FelipeBallesteros0/auto4wd-slam/(list of files, drawings)

Other design files:
docs/cableado/encoders.fzz
docs/cableado/energia.fzz
docs/cableado/motores.fzz
docs/cableado/sensores.fzz
