FelipeBallesteros0/auto4wd-slam/(commit log)

2026-08-31 Robot 4WD: firmware Due (teleop+IMU v2.3), nodo ROS2 (teleop+odometría v5.1), SLAM+Foxglove, mapeo y calibración — estado al 2026-08-31
    Claude-Session: https://claude.ai/code/session_01McgLjqTmVJsofFadiFzMc1
2026-09-01 Calibración de odometría: cuadratura por muestreo 20 kHz (v3.0) + escala empírica 1.0773 (3 runs de 2,10 m con huincha)
    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
2026-09-01 Fix: hotspot es 'Felipe' con mayúscula (SSID case-sensitive)
    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
2026-09-01 Fix: el hotspot es 'Felipe ' con ESPACIO al final (nombre del iPhone); SSID exacto o wpa queda en SCANNING eterno
    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
2026-09-03 IMU robustez: nodo mantiene rumbo en micro-caídas (no encoders-basura); firmware hot-plug sin recalibrar (evita deriva). Giro validado 91.7deg/90deg cuando IMU conecta
    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
2026-09-06 Re-cableado 2026-09-06: tablas por rueda, ENC_SIGN y escaneo I2C en el sketch de mapeo
    Felipe cambió el orden de los pines PWM y de encoders. El firmware teleop
    (v3.2) indexa ahora por rueda en el orden de la telemetría (DI TI DD TD):
    MPIN {12,11},{8,7},{9,10},{5,6}; EPIN (22,23),(26,27),(24,25),(28,29);
    ENC_SIGN {+,+,-,-} porque el lado derecho cuenta al revés (espejo).
    Verificado con test_adelante.py: +3506 +3610 +3573 +3550 en 2 s a PWM 70.
    - mapeo_encoders: comando 'i' (escaneo I2C Wire/Wire1) y escaneo al arrancar.
    - rpi/serial_cmd.py y rpi/test_adelante.py: utilidades usadas desde la Pi.
    - MAPEO_RESULTADO.md: tabla nueva y método a mano (girar ruedas hacia adelante).
    Co-Authored-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
2026-09-06 Sketches de diagnóstico del IMU: niveles I2C (imu_diag) y búsqueda por software en todos los pines (i2c_busca)
    imu_diag: cada 1,5 s mide si SDA20/SCL21 y SDA1/SCL1 están en alto tras
    descargarlos (corto / al aire / pull-up externo) y prueba 0x68/0x69 en Wire a
    100k y 20k y en Wire1 a 20k. i2c_busca: I2C por software con pull-ups internos
    sobre todos los pares ordenados de pines libres, leyendo WHO_AM_I; sirve para
    detectar SDA/SCL invertidos o en pines equivocados. 2026-09-06: ninguno
    encontró el MPU-9250 (LED encendido, líneas sanas): el fallo está en el
    módulo/cables.
    Claude-Session: https://claude.ai/code/session_01NenvcfDpV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
2026-09-06 imu_diag: prueba de driver de pines 20/21, tiempo de NACK del bus y puente SDA-SCL
    Resultado 2026-09-06 con el módulo morado (3V3/SDA/SCL soldados, continuidad
    OK, LED encendido): pines sanos, NACK inmediato en 110 us, sin puente, sin
    respuesta en 0x68/0x69 ni en ninguna otra dirección => el módulo no contesta.
    Claude-Session: https://claude.ai/code/session_01NenvcfDpVKUeq7taTVaSEV
2026-09-06 i2c_simple: escáner I2C mínimo (Wire 20/21 + WHO_AM_I) para descartar error de código
    2026-09-06: tampoco ve nada (endTransmission=2 en 0x68/0x69, ningún
    dispositivo en el barrido). Confirma que el módulo morado no responde.
    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
    [i2c_simple.ino]
2026-09-06 i2c_lento: prueba del IMU de 100 kHz a 5 kHz y 1 kHz por software; teleop a 100 kHz
    Los cables I2C miden ~50 cm. Resultado 2026-09-06: NACK a todas las
    velocidades, también a 1 kHz por software => no es la velocidad, el módulo
    no responde. De todos modos el firmware teleop baja de 400 a 100 kHz, que
    es más robusto con cables largos (posible causa de las caídas por vibración).
    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
2026-09-06 IMU nuevo montado con Z hacia arriba: gyro sin invertir (90° izq = -1614 mrad con el signo viejo)
    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
2026-09-06 IMU: recuperación de bus I2C, lectura a 200 Hz y reintento cada 250 ms
    Causa raíz de las caídas del IMU al andar (2026-09-06): un glitch en SDA/SCL
    deja al MPU a mitad de byte y desde ahí responde NACK a todo; Wire.begin()
    no lo resincroniza y quedaba CAIDO hasta apagar el robot. imu_diag demostró
    que 10 pulsos de SCL + STOP lo reviven. Además se leía el gyro en cada
    vuelta del loop (bus ocupado ~100 %): ahora 200 Hz, la tasa real del MPU.
    Caída declarada a las 5 lecturas fallidas y reintento inmediato/250 ms, con
    el hueco informado en ms en el mensaje R IMU=OK.
    Claude-Session: https://claude.ai/code/session_01NenvcfDpVKUeq7ta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
    [imu_diag.ino, teleop_due.ino]
2026-09-06 IMU: reintento cada 50 ms (el motor del lidar provoca las caídas; 0 sin motor, 24 en 45 s con motor)
    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
2026-09-06 mapper.sh: vigilante del lidar (sin /scan en 25 s => SIGKILL al nodo y relanzar) y bucle infinito
    Tras un restart del servicio, rplidar_composition arrancaba ('RPLIDAR running')
    pero quedaba colgado en nanosleep sin publicar /scan ni atender servicios, e
    ignoraba SIGTERM; con SIGKILL y relanzar vuelve a 8 Hz. Visto 3 veces el
    2026-09-06.
    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
2026-09-06 IMU: detectar bus trabado por nivel de pin (evita 3x100 ms de timeout de Wire); guarda_mapa.py
    Con el bus en bajo cada transacción de Wire agota ~100 ms de timeout: 3
    lecturas fallidas = 300 ms a ciegas (huecos de 337-400 ms medidos en la
    vuelta con giros del 2026-09-06, 11 de 41 caídas). Ahora se lee PIO_PDSR de
    20/21 antes de hablar: trabón detectado en <5 ms, recuperación inmediata.
    rpi/guarda_mapa.py vuelca /map a PGM para revisar el mapa sin Foxglove.
    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
2026-09-06 IMU por I2C de software (bit-bang en 20/21): sin timeouts de 112 ms ni TWI colgada
    Con la TWI por hardware, tras un glitch cada transacción agotaba ~112 ms de
    timeout de Wire aunque el bus estuviera libre (huecos de 115/337/397 ms en
    la vuelta con giros del 2026-09-06, 17 en 5 min). El bit-bang no espera al
    esclavo: un fallo se ve en ~100 us, se resincroniza (10 clocks + STOP) y se
    reintenta la lectura en la misma vuelta. Informe 'R I2C glitches= caidas='
    cada 10 s. Primer arranque: 0 glitches con el lidar girando.
    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
    [teleop_due.ino]
2026-09-06 Lidar montado girado 180°: yaw=pi en la transformada base_link->laser
    Medido con un objeto a 20 cm: al frente del robot el lidar lo ve a -178°,
    a la izquierda a -90° (giro de 180°, sin espejo). Con yaw=0 el SLAM recibía
    cada scan rotado 180° y las traslaciones al revés: mapa en estrella aun con
    el giroscopio perfecto. rpi/scan_min.py: punto más cercano del /scan.
    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
2026-09-06 rpi/scan_min.py: punto más cercano del /scan (test de orientación del lidar)
    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
2026-09-06 teleop_ros: gancho /tmp/AUTO_GIRO (PWM fijos por N s, giros controlados sin mando); rpi/overlay.py
    overlay.py dibuja el scan actual sobre /map usando TF y mide qué fracción de
    puntos cae en celdas ocupadas. 2026-09-06 tras corregir lidar 180° + IMU:
    669/672 puntos (100 %) sobre pared => el scan calza con el mapa.
    Giro lento por software (PWM 40/-40 ≈ 8°/s) para probar el SLAM sin depender
    de la velocidad del mando.
    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
2026-10-26 docs: diagramas de cableado (energía, motores, encoders, sensores) con piezas de Fritzing
    [encoders.fzz, energia.fzz, motores.fzz, sensores.fzz]
2026-10-26 rpi: odom_encoders (odometría solo con encoders, para comparar con el giroscopio)
2026-10-28 rpi: quita odom_encoders (era solo para una toma del video y nunca corrió en el auto); README: nota sobre RPWM/LPWM
2026-10-28 README: el pack es de Samsung ICR18650-26J (no INR18650)
